MusaMahmood/PCB-HR-RR/hr_rr/hr_rr.kicad_pcb

## KiCad design hr_rr/hr_rr.kicad_pcb (2018-12-13)

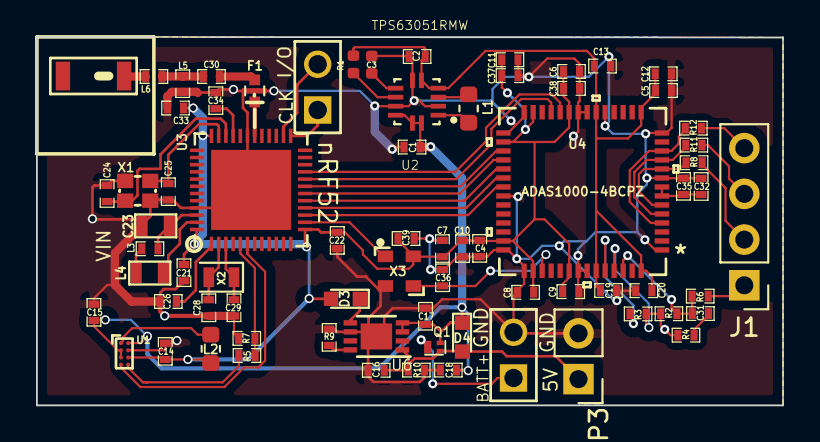
[picture p1: board hr_rr.kicad_pcb from above]

Board: 2 copper layers, 41.5 x 20.5 mm, 73 parts (0 on the bottom side), 52 nets.

Parts:
A1: CHIP-ANT; JTI-2450AT18A100-CHIP-ANT
C1: 10µF; SM0402
C2: 22µF; SM0402
C3: 1nF; C_0402_1005Metric
C4, C5, C16, C17: 4.7uF; SM0402
C6, C7, C8, C9, C10, C11, C12, C13, C19, C20, C32, C39: 0.1uF; SM0402
C14, C15, C35: 10uF; SM0402
C18: 1.0uF; SM0402
C21: 4.7µF; SM0402
C22, C26, C33: 100nF; SM0402
C23: 1.0µF; SM0603
C24, C25, C28, C29: 12pF; SM0402
C30: 1.0pF; SM0402
C31: 2.2 nF; SM0402
C34: 100pF; SM0402
C36: 15pF; SM0402
C37, C38: 2.2uF; SM0402
D3: LED; LED_0603
D4: D_Schottky; LED_0603
F1: 2450FM07A0029; R_0402
J1: Electrodes; PinHeader_1x04_P2.54mm_Vertical
L1, L2: 2.20 µH; L_0603_1608Metric
L3: 15nH; SM0402
L4: 10uH; SM0603
L5: 2.7 nH; SM0402
L6: 3.9 nH; SM0402
P1, P2: Conn_01x02_Male; PIN_ARRAY_2X1
P3: Conn_01x02_Male; Pin_Header_Straight_1x02_Pitch2.54mm
Q1: DMP21D5UFB4-7B; X2-DFN1006
R1: 1M; R_0402_1005Metric
R2: 4M; SM0402
R3: 40k; SM0402
R4, R10: 100k; SM0402
R5, R7: 1M; SM0402
R6, R8, R11, R12: 30k; SM0402
R9: 2k; SM0402
U1: TPS62746; XBGA-8
U2: TPS63051RMW; QFN50P250X250X100-12N
U3: NRF528XX-QFAA; UQFN-48-1EP_6x6mm_Pitch0.4mm
U4: ADAS1000-4BCPZ
U6: MCP73831; DFN-8-1EP_3x2mm_Pitch0.5mm
X1: Crystal_GND24; CRYSTAL-SMD-2.0MMx1.6MM
X2: 32.768 kHz; Crystal_SMD_2012-2pin_2.0x1.2mm
X3: DSC1001; DSC1001DI5-008.1920T

Connections:
1.8V_supply: C4.2, C6.2, C7.2, C8.2, C9.2, C10.2, C11.2, C14.1, C21.2, C22.1, C33.2, C37.2, C38.2, C39.2, D3.2, L2.2, U1.C2, U3.13, U3.36, U3.48, U4.23, U4.27, U4.30, U4.41, U4.44, U4.48, X3.4
3.3V_supply: C2.1, C5.2, C12.2, C13.2, C19.2, C20.2, R1.1, U2.4, U2.5, U4.15, U4.20, U4.51, U4.56
5V_in_charge: C16.1, D4.2, P3.1, Q1.1, R10.1, U6.1, U6.2
/AIN_BAT_DIV_VOLTAGE: R5.2, R7.2, U3.5
/CLK_DSC1001_STANDBY: U3.14, X3.1
/DEC1: C26.1, U3.1
/DEC3: C34.1, U3.33
/DSC1001_CLK_OUT: C36.1, U4.45, X3.3
/LOAD_SW_CTRL: U1.D1, U3.6
/RF: C30.1, F1.4
/RLD_BIAS_ELECTRODE: J1.1, R6.2
/SCLK: U3.18, U4.32
/SDI: U3.17, U4.33
/SDO: U3.19, U4.31
/SWDCLK: P2.1, U3.25
/SWDIO: P2.2, U3.26
/VREF: C32.1, C35.1, U4.7, U4.8
/e_LA: J1.2, R8.1
/e_LL: J1.3, R11.1
/e_RA: J1.4, R12.1
/~CS: U3.15, U4.35
/~DRDY: U3.16, U4.34
/~PWDN: U3.20, U4.25
/~RESET: U3.21, U4.24
BATT_V: P1.1, Q1.2
DGND: C1.2, C2.2, C3.2, C4.1, C5.1, C6.1, C7.1, C8.1, C9.1, C10.1, C11.1, C12.1, C13.1, C14.2, C15.2, C16.2, C17.2, C18.1, C19.1, C20.1, C21.1, C22.2, C23.2, C24.1, C25.1, C26.2, C28.2, C29.2, C32.2, C33.1, C34.2, C35.2, C36.2, C37.1, C38.1, C39.1, F1.1, F1.3, L5.2, P1.2, P3.2, R7.1, R9.2, R10.2, U1.B2, U2.2, U2.6, U2.9, U3.31, U3.45, U3.49, U4.1, U4.9, U4.14, U4.19, U4.21, U4.22, U4.28, U4.29, U4.36, U4.42, U4.43, U4.49, U4.50, U6.6, U6.9, X1.2, X1.4, X3.2
unnamed: A1.1, L6.2
unnamed: C3.1, U2.7
unnamed: C23.1, L3.2, U3.46
unnamed: C24.2, U3.34, X1.1
unnamed: C25.2, U3.35, X1.3
unnamed: C28.1, U3.2, X2.2
unnamed: C29.1, U3.3, X2.1
unnamed: C30.2, L5.1, L6.1
unnamed: C31.1, R4.1
unnamed: C31.2, R2.1, R6.1, U4.54
unnamed: D3.1, U6.5
unnamed: F1.2, U3.30
unnamed: L1.1, U2.3
unnamed: L1.2, U2.1
unnamed: L2.1, U1.A1
unnamed: L3.1, L4.2
unnamed: L4.1, U3.47
unnamed: R1.2, U2.8
unnamed: R2.2, R3.2, R4.2, U4.53
unnamed: R3.1, U4.52
unnamed: R5.1, U1.D2
unnamed: R8.2, U4.6, U4.10
unnamed: R9.1, U6.8
unnamed: R11.2, U4.5, U4.11
unnamed: R12.2, U4.4, U4.12
Vcc<BATT>: C1.1, C15.1, C17.1, C18.2, D4.1, Q1.3, U1.A2, U1.B1, U1.C1, U2.10, U2.11, U2.12, U6.3, U6.4
