MusaMahmood/PCB-HR-RR/(threads)

Thread 2 (2018-11-24):

Wrong BGA footprint size for TPS62746

MusaMahmood, 2018-11-24:

Closed 2018-12-13.

Thread 4 (2018-12-05):

Fix CMOS Clock Configuration (DSC1001 Outputs to CLK_IN on ADAS)

MusaMahmood, 2018-12-05:
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

DSC1001 CMOS Clock should not output to XTAL Pins! it should output to CLK_IN on the ADAS.

Easy enough fix.

- [ ] Disconnect DSC/GND from XTAL pins (leave floating ??)
- [ ] Connect DSC output to CLK_IN

Closed 2018-12-13.
