MusaMahmood/PCB-HR-RR/(commit log)

2018-10-25 ADAS1000 Libraries + Starting Schematic.
    [hr_rr.kicad_pcb, hr_rr.sch]
2018-10-25 Added necessary components to schematic, pcb. Need to route, and add passive components.
    [hr_rr.kicad_pcb, hr_rr.sch]
2018-10-25 Updated Power Supply Circuitry.
    [hr_rr.sch]
2018-10-26 Restored original nRF52832 design.
    [hr_rr.kicad_pcb, hr_rr.sch, hr_rr_v2.sch]
2018-10-26 Restored old PCB, reassigned new one. Removed unneeded components.
    [hr_rr.kicad_pcb, hr_rr.sch, hr_rr_v2.kicad_pcb]
2018-10-26 Updated components with new voltage regulators in schematic.
    [hr_rr.sch]
2018-10-26 Cleaned PCB of old voltage regulators.
    [hr_rr.kicad_pcb, hr_rr.sch]
2018-10-26 Remove old/unneeded files.
    [hr_rr_v2.kicad_pcb, hr_rr_v2.sch]
2018-10-26 Updated Component-Footprint Associations for Voltage Regulators.
    [hr_rr.sch]
2018-10-26 Minor adjustments to schematic, cleanup.
    [hr_rr.sch]
2018-10-26 Updated all outdated footprint associations. Updated PCB to include new footprints (not wired).
    [hr_rr.sch]
2018-10-26 Updated footprint to include new footprints.
    [hr_rr.kicad_pcb]
2018-10-26 Changed TPS63051 to VQFN Version, integrated power components.
    [hr_rr.kicad_pcb, hr_rr.sch]
2018-10-28 Re-added libraries as relative paths.
    [hr_rr.sch]
2018-10-28 Added CLK sch components, updated libraries, added ADAS to schematic.
    [hr_rr.sch]
2018-10-28 Added footprint for CMOS clock, added to PCB.
    [hr_rr.kicad_pcb, hr_rr.sch]
2018-10-29 Completed ADAS1000-4 portion, finalized PCB.
    [hr_rr.kicad_pcb, hr_rr.sch]
2018-10-29 Added missing decoupling caps.
    [hr_rr.kicad_pcb, hr_rr.sch]
2018-10-29 Fixed via annular ring size, trace near edge.
    [hr_rr.kicad_pcb, hr_rr.sch]
2018-12-13 (Fixed #4) CMOS Clock Reconfigure
    [hr_rr.kicad_pcb, hr_rr.sch]
2018-12-13 (Fixed #3) Shorted EN, ILIM0 to Vcc, also removed PG from reset pin.
    [hr_rr.kicad_pcb, hr_rr.sch]
2018-12-13 Fixed #2, updated BGA pattern.
    [hr_rr.kicad_pcb]
